wirbel-at-vdr-portal/bitmap-clock/README.md

# Bitmap Clock
The idea of an 6-digit (actually eight: six numbers plus two digits showing a blinking separator) Nixie-like clock, using eight 1.69" 280x240 ST7789 IPS LCDs.

It displays the time as hh:mm:ss (eight displays) in CET.

## List of components
* Arduino Nano ESP32
* RTC DS3231SN
* 8x 1.69" 280x240 ST7789 IPS LCD
* 4x 74LVT244A + 8x 1k pullup resistors for driving eight chip select pins
* REG1117 3.3V
* 2x 4.7k pullup resistors for I2C

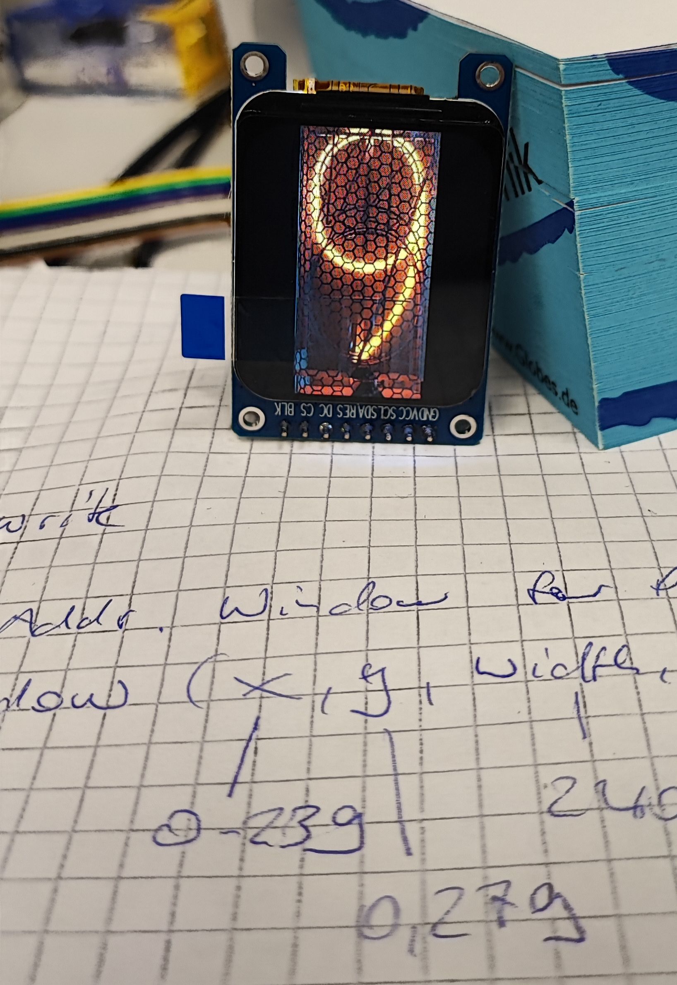
[picture p1: doc/Ziffer.jpg]
Ziffer 9


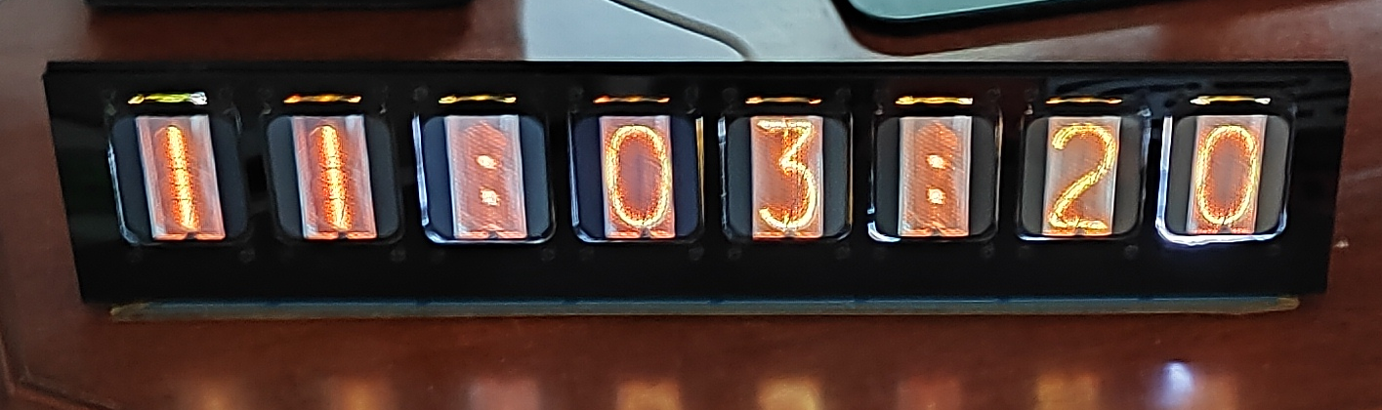
[picture p2: doc/20250621.png]
overview


# Features
* Nixie feeling
* No trouble after power cut, just continue working
* RTC running at local time (saves a bit computing every second)
* NTP via WiFi, keeping the RTC up to date
* Time shown in CET (UTC+1 + summer time)
* Powered via USB-C

## Current Status
* design prototype PCB -> done
* produce and assemble prototype -> done
* driving all digits requires takes ~ 60% of the avail memory. -> plenty of space left for fun things
* The IPS displays and the RTC should use tiny(!) libs. -> done
* Speed up TFTs as much as possible -> done
* check multiplexing -> done. Found one missing 1k pullup resistor per digit; fixed for prototype
* check I2C -> done. Found two missing 4.7k pullup resistors for SDA & SCK; fixed for prototype
* check SPI speed -> done. No problem at all, the default of 32MHz runs nice. Setting it SPI clk to 80MHz doesn't change anything - to be measured.
* check RTC accuracy -> nice. Less a second in 24h
* 20250223: first successful firmware. IPS displays are actually GREAT in terms of display angle.
* 20250225: RTC works. Showing actual time now on display.
* 20250226: NTP via wifi works nice. About 22% available memory for a demo sketch; but dealing with WiFi interruptions to be integrated.
* 20250227: combined in one firmware. RTC is now set per NTP und updated regularly.
* 20250228: firmware considered stable, reduced NTP update interval to 15 minutes
* 20250517: display frame (front+back) laser cutted && mounted; fixed firmware bug, if no ntp update while daylight saving change

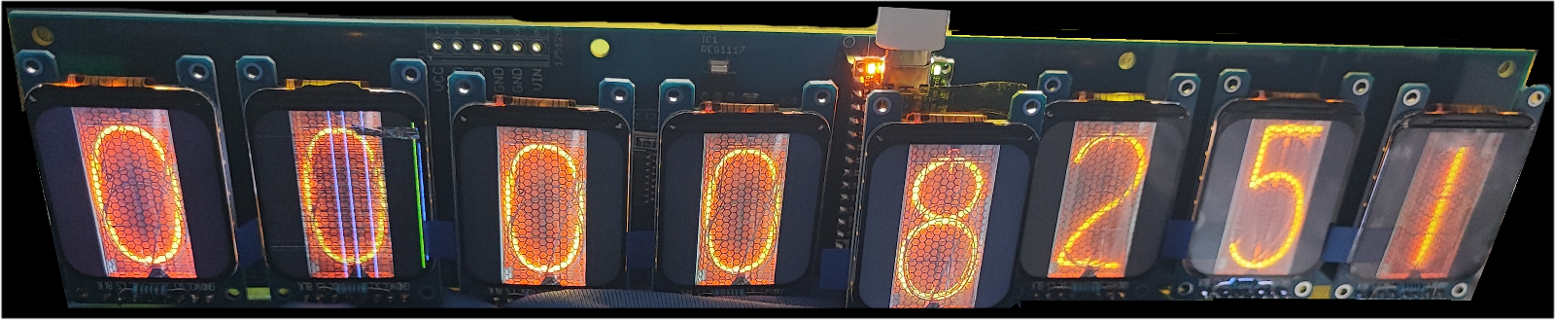
[picture p3: doc/Prototype.png]
Prototype


## Measured current consumption
* 5V @ 280mA
* This is for running eight displays at max speed, with the RTC idle.
* no need to use the external REG1117

## Display update Time:
* to update all eight digits, we need ~ 0.3sec
* i can save time, if updating only digits, which actually changed their value -> done
