wirbel-at-vdr-portal/bitmap-clock/doc/doc/Nano_ESP32_pinout.png

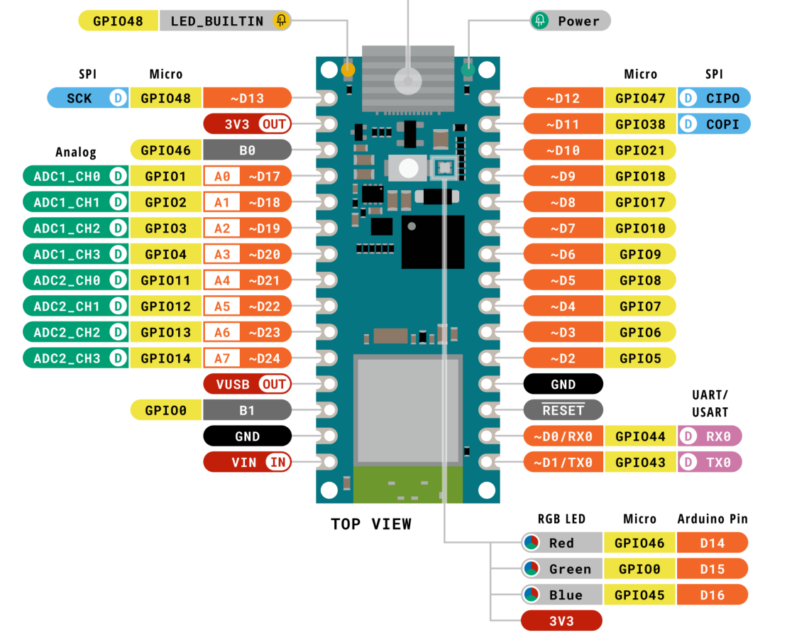
doc/doc/Nano_ESP32_pinout.png
