wirbel-at-vdr-portal/bitmap-clock/doc/DS3231_Pinout.png

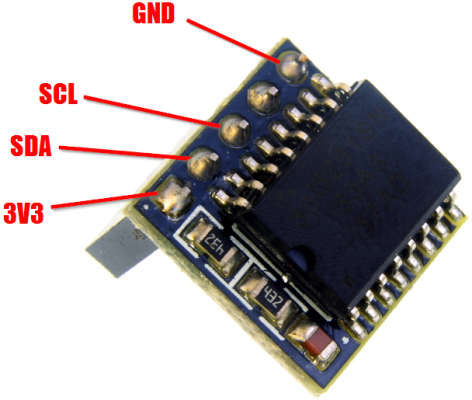
doc/DS3231_Pinout.png
