wirbel-at-vdr-portal/bitmap-clock/doc/overview_small.bmp

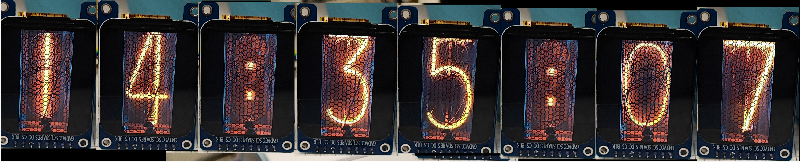
doc/overview_small.bmp
