wirbel-at-vdr-portal/bitmap-clock/firmware/DS3231.cpp

/*******************************************************************************
 * This file is part of bitmap-clock.
 * https://github.com/wirbel-at-vdr-portal/bitmap-clock
 * See the README file for copyright information and how to reach the author.
 ******************************************************************************/

#include "DS3231.h"
#include <Arduino.h>
#include <Wire.h>

/*
 *--------------------------------------------------------------------------------------------------------------
 * ADDRESS  | BIT 7 | BIT 6 | BIT 5 | BIT 4 | BIT 3 | BIT 2 | BIT 1 | BIT 0 | FUNCTION        | RANGE
 *--------------------------------------------------------------------------------------------------------------
 * 00h      | 0     | ---- 10 Seconds ----- | ---------- Seconds ---------- | Seconds         | 00–59
 *          |___________________________________________________________________________________________________
 * 01h      | 0     | ---- 10 Minutes ----- | ---------- Minutes ---------- | Minutes         | 00–59
 *          |___________________________________________________________________________________________________
 * 02h      | 0     |12/n24 |nAM/PM |10 Hour| ---------- Hour ------------- | Hours           | 1–12 + AM/PM
 *          |       |       |20 Hour|       |                               |                 | 00–23
 *          |___________________________________________________________________________________________________
 * 03h      | 0     | 0     | 0     | 0     | 0     | -------- Day -------- | Day             | 1–7
 *          |___________________________________________________________________________________________________
 * 04h      | 0     | 0     | --- 10 Date - | ---------- Date ------------- | Date            | 01–31
 *          |___________________________________________________________________________________________________
 * 05h      |Century| 0     | 0     |10Month| ---------- Month ------------ | Month/Century   | 01–12 + Century
 *          |___________________________________________________________________________________________________
 * 06h      | -------- 10 Year ------------ | ---------- Year ------------- | Year            | 00–99
 *          |___________________________________________________________________________________________________
 * 07h      | A1M1  | ---- 10 Seconds ----- | ---------- Seconds ---------- | Alarm 1 Seconds | 00–59
 *          |___________________________________________________________________________________________________
 * 08h      | A1M2  | ---- 10 Minutes ----- | ---------- Minutes ---------- | Alarm 1 Minutes | 00–59
 *          |___________________________________________________________________________________________________
 * 09h      | A1M3  |12/n24 |nAM/PM  10 Hour| ---------- Hour ------------- | Alarm 1 Hours   | 1–12 + AM/PM
 *          |       |       |20 Hour        |                               |                 | 00–23
 *          |___________________________________________________________________________________________________
 * 0Ah      | A1M4  |DY/nDT |--- 10 Date -- | ---------- Day -------------- | Alarm 1 Day     | 1–7
 *          |       |       |               | ---------- Date ------------- | Alarm 1 Date    | 1–31
 *          |___________________________________________________________________________________________________
 * 0Bh      | A2M2  | ---- 10 Minutes ----- | ---------- Minutes ---------- | Alarm 2 Minutes | 00–59
 *          |___________________________________________________________________________________________________
 * 0Ch      | A2M3  |12/n24 |nAM/PM  10 Hour| ---------- Hour ------------- | Alarm 2 Hours   | 1–12 + AM/PM
 *          |       |       |20 Hour        |                               |                 | 00–23
 *          |___________________________________________________________________________________________________
 * 0Dh      | A2M4  |DY/nDT |--- 10 Date -- | ---------- Day -------------- | Alarm 2 Day     | 1–7
 *          |       |       |               | ---------- Date ------------- | Alarm 2 Date    | 1–31
 *          |___________________________________________________________________________________________________
 * 0Eh      | nEOSC | BBSQW | CONV  | RS2   | RS1   | INTCN | A2IE  | A1IE  | Control         | —
 * 0Fh      | OSF   | 0     | 0     | 0     |EN32kHz| BSY   | A2F   | A1F   | Control/Status  | —
 * 10h      | SIGN  | DATA  | DATA  | DATA  | DATA  | DATA  | DATA  | DATA  | Aging Offset    | —
 * 11h      | SIGN  | DATA  | DATA  | DATA  | DATA  | DATA  | DATA  | DATA  | MSB of Temp     | —
 * 12h      | DATA    DATA    0       0       0       0       0     | 0     | LSB of Temp     | —
 */

static const uint8_t I2C_address = 0x68;

/*******************************************************************************
 * forward decls
 ******************************************************************************/
int BCD2Decimal(uint8_t bcd);
uint8_t DecimalToBCD(int d);
uint8_t TwoCharsToByte(char* s);
uint8_t DayOfWeek(uint16_t y, uint8_t m, uint8_t d);
bool leap(uint16_t y);


/*******************************************************************************
 * class DS3231
 ******************************************************************************/

DS3231::DS3231() {
}

void DS3231::begin() {
  ReadRegisters(0, 1+0x12, reg);
}

void DS3231::ReadRegisters(uint8_t reg, uint8_t count, uint8_t* dest) {
  Wire.beginTransmission(I2C_address);
  Wire.write(reg);
  Wire.endTransmission();

  Wire.requestFrom(I2C_address, count);
  for(int i=0; Wire.available(); i++)
     dest[i] = Wire.read();
}

void DS3231::WriteRegister(uint8_t reg, uint8_t val) {
  Wire.beginTransmission(I2C_address);
  Wire.write(reg);
  Wire.write(val);
  Wire.endTransmission(true);
}

void DS3231::GetTime(struct Time* tm) {
  ReadRegisters(0, 1+0x12, reg);
  tm->Seconds = BCD2Decimal(reg[0x00] & 0x7F);
  tm->Minutes = BCD2Decimal(reg[0x01] & 0x7F);
  bool AM_PM = (reg[0x02] & 0x40) > 0;
  if (AM_PM) {
     tm->Hours = BCD2Decimal(reg[0x02] & 0x1F);
     if ((reg[0x02] & 0x20) > 0)
        tm->Hours += 12;
     }
  else {
     tm->Hours = BCD2Decimal(reg[0x02] & 0x3F);
     }
  tm->Days = reg[0x03] & 0x7;
  tm->Date = BCD2Decimal(reg[0x04] & 0x3F);
  tm->Month = BCD2Decimal(reg[0x05] & 0x1F);
  bool Century = (reg[0x05] & 0x80) > 0;
  tm->Year = BCD2Decimal(reg[0x06]);
  if (Century)
     tm->Year += 2000;
}

void DS3231::SetTime(struct Time* tm) {
  ReadRegisters(0, 1+0x12, reg);
  WriteRegister(0x0F, reg[0x0F] & 0x7F);
  WriteRegister(0x00, DecimalToBCD(tm->Seconds));    // 00–59
  WriteRegister(0x01, DecimalToBCD(tm->Minutes));    // 00–59
  WriteRegister(0x02, DecimalToBCD(tm->Hours));      // 00–23
  WriteRegister(0x03, tm->Days);                     // 1–7
  WriteRegister(0x04, DecimalToBCD(tm->Date));       // 01–31
  uint8_t reg05 = DecimalToBCD(tm->Month);           // 01-12
  if (tm->Year >= 2000) reg05 |= 0x80;               // Century flag
  WriteRegister(0x05, reg05);                        // 01–12 + Century
  WriteRegister(0x06, DecimalToBCD(tm->Year % 100)); // 00–99
}

bool DS3231::TimeIsValid(void) {
  ReadRegisters(0, 1+0x12, reg);
  return (reg[0x0F] & 0x80) == 0;
}

bool DS3231::Summer(void) {
  ReadRegisters(0, 1+0x12, reg);
  return (reg[0x0D] & 0x40) > 0;
}

void DS3231::DaylightOffset(bool On) {
  ReadRegisters(0, 1+0x12, reg);
  if (On)
     reg[0x0D] |= 0x40;
  else
     reg[0x0D] &= ~0x40;
  WriteRegister(0x0D, reg[0x0D]);
}

void DS3231::PrintDateTime(struct Time* tm, char* buf) {
  int y;
  uint8_t p = 0;
  buf[p++] = '0' + tm->Date / 10;
  buf[p++] = '0' + tm->Date % 10;
  buf[p++] = '.';
  buf[p++] = '0' + tm->Month / 10;
  buf[p++] = '0' + tm->Month % 10;
  buf[p++] = '.';
  buf[p++] = '0' + tm->Year / 1000; y = tm->Year % 1000;
  buf[p++] = '0' + y        / 100;  y = y % 100;
  buf[p++] = '0' + y        / 10;   y = y % 10;
  buf[p++] = '0' + y;
  buf[p++] = ' ';
  buf[p++] = '0' + tm->Hours / 10;
  buf[p++] = '0' + tm->Hours % 10;
  buf[p++] = ':';
  buf[p++] = '0' + tm->Minutes / 10;
  buf[p++] = '0' + tm->Minutes % 10;
  buf[p++] = ':';
  buf[p++] = '0' + tm->Seconds / 10;
  buf[p++] = '0' + tm->Seconds % 10;
  buf[p++] =  0;
}

void DS3231::PrintTime(struct Time* tm, char* buf) {
  uint8_t p = 0;
  buf[p++] = '0' + tm->Hours / 10;
  buf[p++] = '0' + tm->Hours % 10;
  buf[p++] = ':';
  buf[p++] = '0' + tm->Minutes / 10;
  buf[p++] = '0' + tm->Minutes % 10;
  buf[p++] = ':';
  buf[p++] = '0' + tm->Seconds / 10;
  buf[p++] = '0' + tm->Seconds % 10;
  buf[p++] =  0;
}

void DS3231::ParseDateTime(struct Time* tm, char* datetime) {
  // check string to be 'dd.mm.yyyy HH:MM:SS'
  for(int i=0; i<19; i++) if (datetime[i] == 0) return;
  if (datetime[19] != 0) {
     Serial.println("null termination check failed.");
     return;
     }
  if (datetime[ 2] != '.') {
     Serial.println("first date dot missing");
     return;
     }
  if (datetime[ 5] != '.') {
     Serial.println("second date dot missing");
     return;
     }
  if (datetime[13] != ':') {
     Serial.println("first time colon missing");
     return;
     }
  if (datetime[16] != ':') {
     Serial.println("second time colon missing");
     return;
     }

  tm->Date    = TwoCharsToByte(datetime); datetime += 3;  // 01–31
  tm->Month   = TwoCharsToByte(datetime); datetime += 3;  // 01-12
  tm->Year    = TwoCharsToByte(datetime); datetime += 2;  // 20xx
  tm->Year   *= 100;
  tm->Year   += TwoCharsToByte(datetime); datetime += 3;  // 20xx
  tm->Days    = DayOfWeek(tm->Year, tm->Month, tm->Date); // 1–7
  tm->Hours   = TwoCharsToByte(datetime); datetime += 3;  // 00–23
  tm->Minutes = TwoCharsToByte(datetime); datetime += 3;  // 00–59
  tm->Seconds = TwoCharsToByte(datetime);                 // 00–59
}

int64_t DS3231::Time_t(struct Time* tm) {
  const uint8_t dim[] = {31, 28, 31, 30, 31, 30, 31, 31, 30, 31, 30, 31};
  int64_t t =  tm->Seconds +           // 0-61
              (tm->Minutes * 60L) +    // 0-59
              (tm->Hours * 3600L);     // 0-23

  uint16_t days = tm->Date - 1; // 1-31
  for(uint8_t i=1; i<tm->Month; i++) {
     days += dim[i-1];
     if (i == 2 and leap(tm->Year)) days++;
     }
  for(uint16_t y=1970; y<tm->Year; y++)
     days += leap(y) ? 366 : 365;
  t += (days * 86400L);
  return t;
}

void DS3231::SetControl(uint8_t flag, bool On) {
  ReadRegisters(0, 1+0x12, reg);
  if (On)
     reg[0x0E] |= flag;
  else
     reg[0x0E] &= ~flag;
  WriteRegister(0x0E, reg[0x0E]);
}

void DS3231::EnableOscillatorOnBattery(bool On) {
  SetControl(0x80, not On); // inverted
}

void DS3231::EnableSquareWaveOnBattery(bool On) {
  SetControl(0x40, On);
}

void DS3231::SquareWaveRate(uint8_t Rate) {
  if (Rate > 3)
     return;
  ReadRegisters(0, 1+0x12, reg);
  reg[0x0E] &= ~0x18;
  reg[0x0E] |= (Rate << 3);
  WriteRegister(0x0E, reg[0x0E]);
}
 
void DS3231::Pin3SquareWave(bool On) {
  SetControl(0x04, On);
}

void DS3231::EnableAlarm1(bool On) {
  SetControl(0x01, On);
}

void DS3231::EnableAlarm2(bool On) {
  SetControl(0x02, On);
}

void DS3231::Enable32kHzOutput(bool On) {
  ReadRegisters(0, 1+0x12, reg);
  if (On)
     reg[0x0F] |= 0x08;
  else
     reg[0x0F] &= ~0x08;
  WriteRegister(0x0F, reg[0x0F]);
}

void DS3231::SetAgingOffset(int8_t value) {
  WriteRegister(0x10, value);
  bool busy;
  do {
     ReadRegisters(0, 1+0x12, reg);
     busy = (reg[0x0F] & 0x04) > 0;
     if (busy) {
        Serial.println("waiting - device is busy executing TCXO functions.");
        delay(100);
        }
     } while(busy);
  WriteRegister(0x0E, reg[0x0E] | 0x20);
}

float DS3231::Temperature(void) {
  ReadRegisters(0, 1+0x12, reg);
  float f = (int8_t) reg[0x11];
  f += (reg[0x12] >> 6) / 4.0f;
  return f;
}

int BCD2Decimal(uint8_t bcd) {
  return (bcd & 0xF) + 10 * (bcd >> 4);
}

uint8_t DecimalToBCD(int d) {
  return (d % 10) | ((d / 10) << 4);
}

uint8_t TwoCharsToByte(char* s) {
  uint8_t u  = (*s++ - '0') * 10;
          u += (*s   - '0');
  return u;
}

uint8_t DayOfWeek(uint16_t y, uint8_t m, uint8_t d) {
  m = (m + 9) % 12;
  y -= m / 10;
  uint32_t dn = 365 * y + y/4 - y/100 + y/400 + (m*306 + 5)/10 + (d - 1);
  dn += 3;
  dn %= 7;
  if (dn == 0) dn = 7;
  return dn;
}

bool leap(uint16_t y) {
  return ((y % 4 == 0 && y % 100 != 0) || y % 400 == 0);
}
