wirbel-at-vdr-portal/bitmap-clock/(commit log)

2025-01-27 fix for line end; CR vs NL+CR
    [DS3231.cpp]
2025-01-28 Nano ESP32 data
2025-01-28 Add Nano ESP32 pinout
2025-02-24 remove GD25B128E from project: enough mem in ESP32
2025-02-24 Image Prototype
2025-02-28 add correction message on Serial
    [DS3231.cpp, DS3231.h, firmware.ino]
